SteBe01/SpacePropulsion/cad/Engine.SLDASM

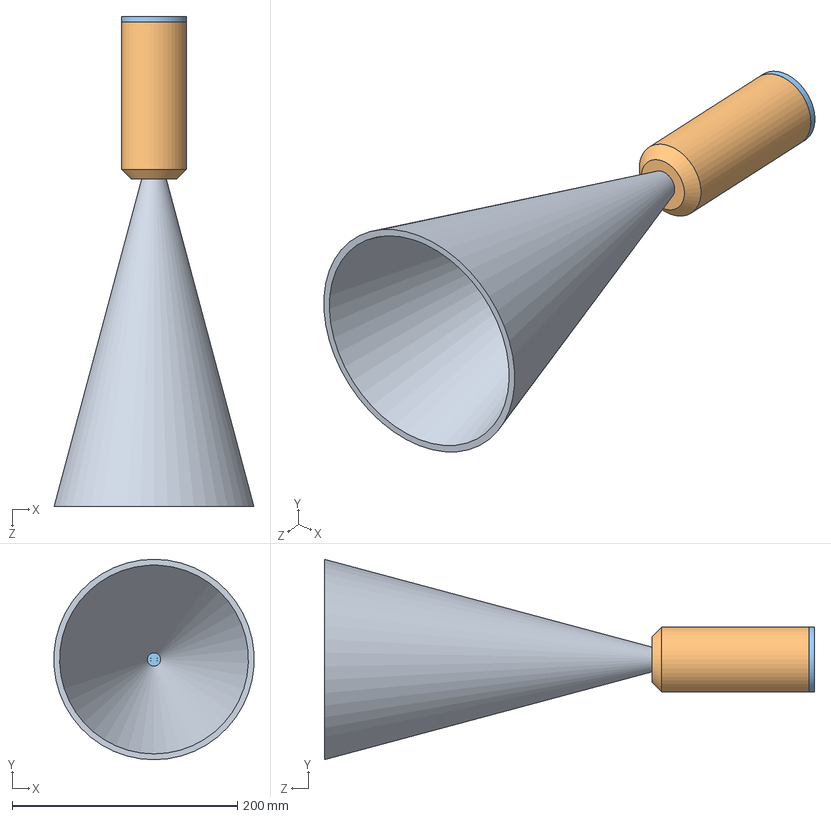
[picture p20: CAD file, 2024-04-17]
cad/Engine.SLDASM
177.7 x 178.2 x 435.8 mm
Injection_plate
Combustion_chamber_and_convergent
Nozzle_conical
