SteBe01/SpacePropulsion/cad/FEM.SLDPRT

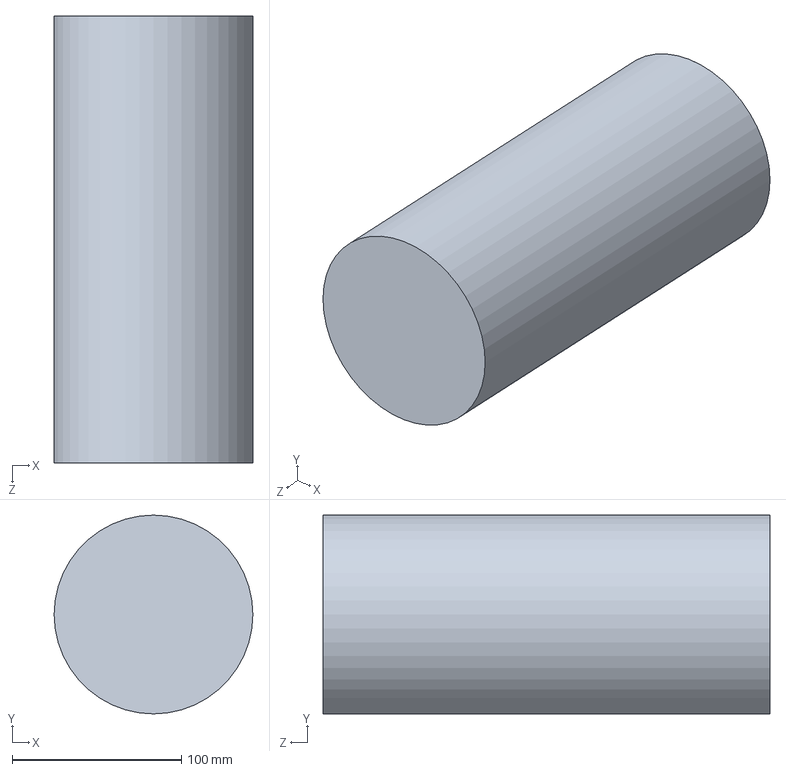
[picture p21: CAD file, 2024-04-17]
cad/FEM.SLDPRT
117.4 x 117.4 x 264.0 mm
