SteBe01/SpacePropulsion/cad/Rao1.SLDPRT

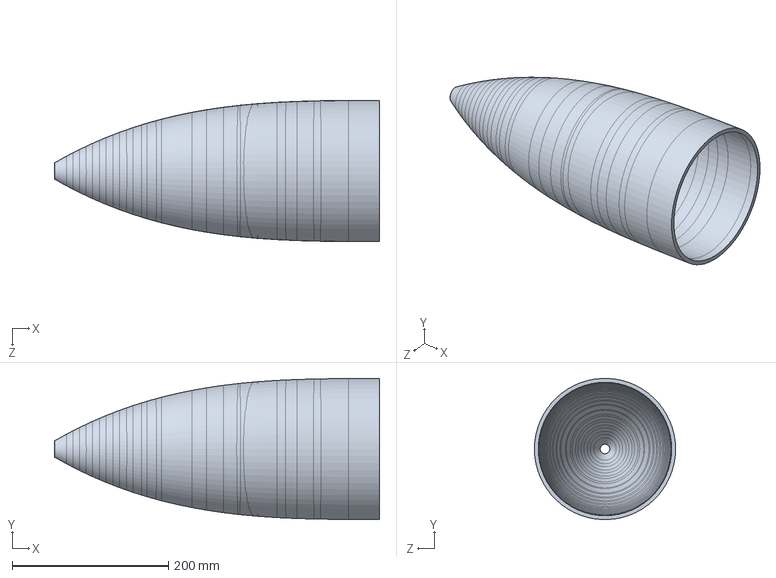
[picture p22: CAD file, 2024-04-17]
cad/Rao1.SLDPRT
415.6 x 180.3 x 180.6 mm
