SteBe01/SpacePropulsion/cad/Rao2.SLDPRT

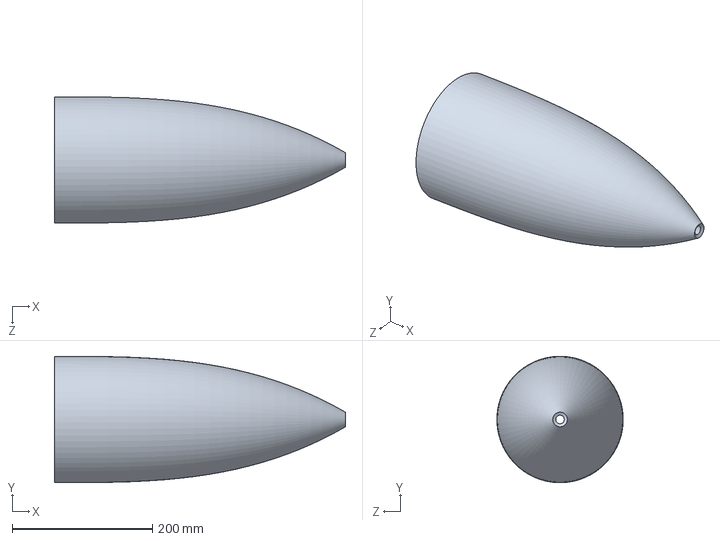
[picture p23: CAD file, 2024-04-17]
cad/Rao2.SLDPRT
415.6 x 180.6 x 180.5 mm
