SteBe01/SpacePropulsion/cad/Nozzle_conical.SLDPRT

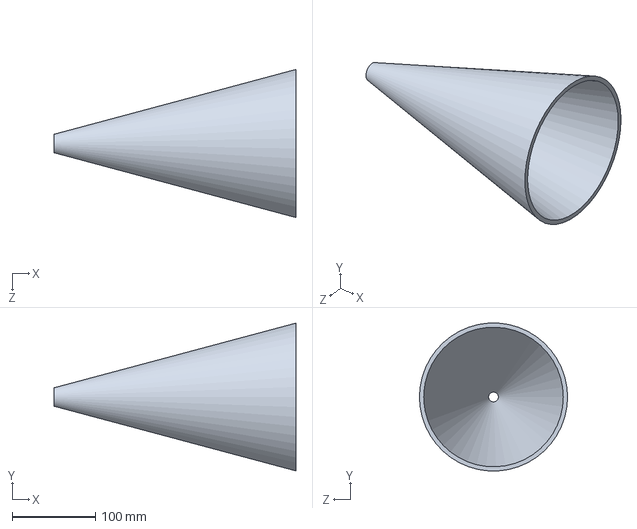
[picture p24: CAD file, 2024-04-17]
cad/Nozzle_conical.SLDPRT
291.0 x 177.7 x 178.2 mm
