SteBe01/SpacePropulsion/cad/Injection_plate.SLDPRT

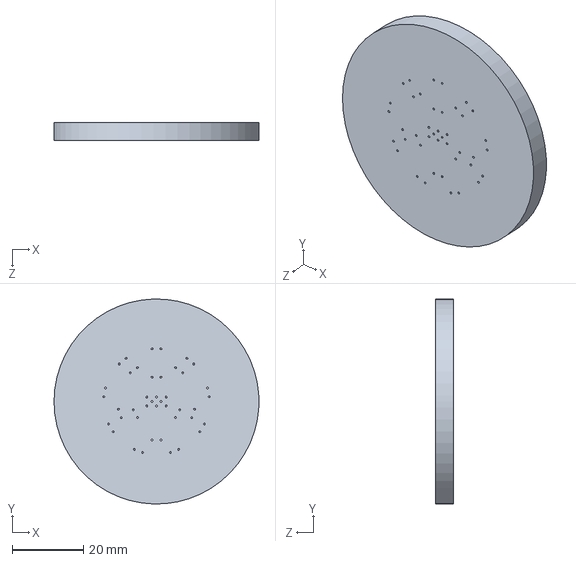
[picture p25: CAD file, 2024-04-17]
cad/Injection_plate.SLDPRT
57.6 x 57.6 x 5.00 mm
