SteBe01/SpacePropulsion/cad/Tank_ox.SLDPRT

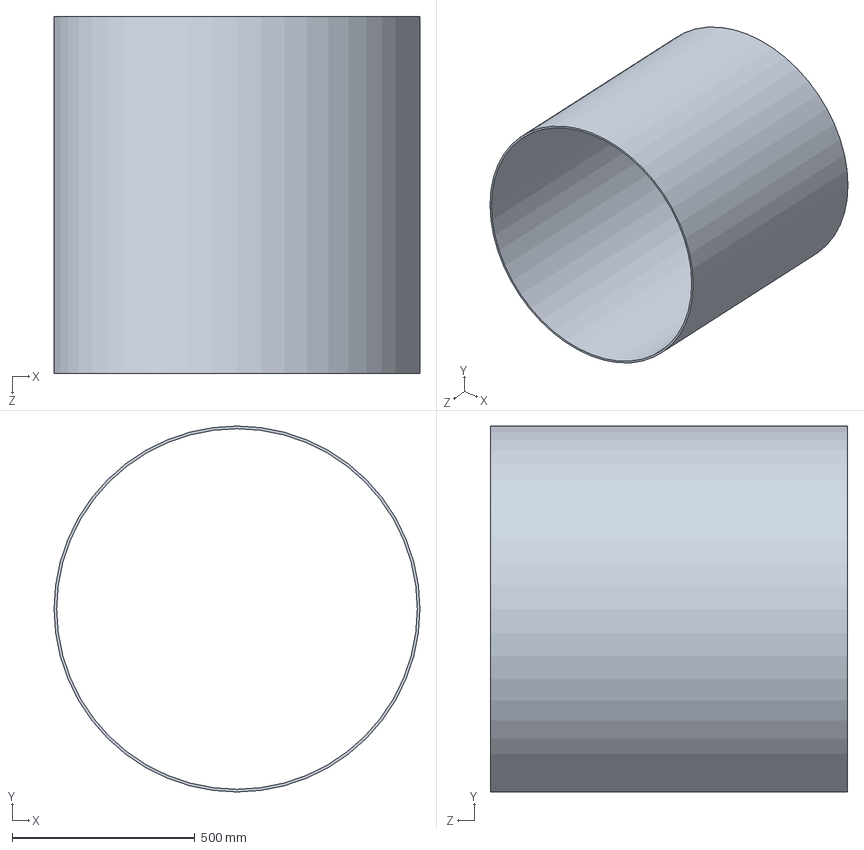
[picture p26: CAD file, 2024-04-14]
cad/Tank_ox.SLDPRT
1000.0 x 1000.0 x 975.5 mm
