SteBe01/SpacePropulsion/cad/Tank_fu.SLDPRT

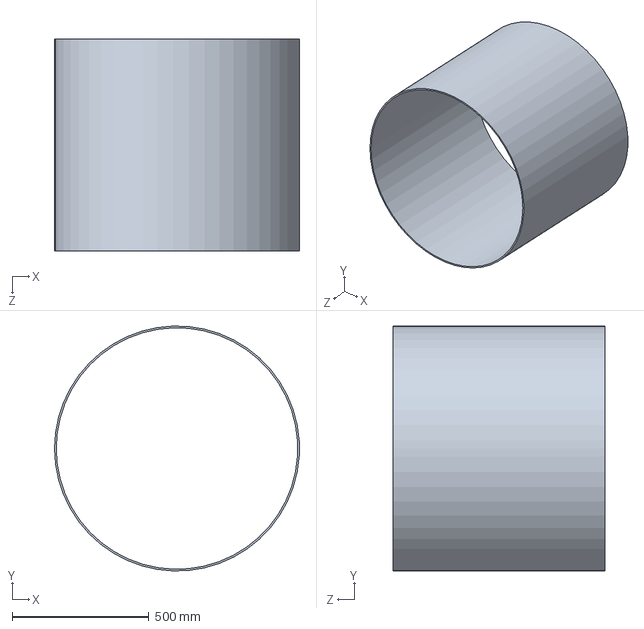
[picture p27: CAD file, 2024-04-14]
cad/Tank_fu.SLDPRT
896.6 x 896.1 x 776.3 mm
