SteBe01/SpacePropulsion/cad/Combustion_chamber_and_convergent.SLDPRT

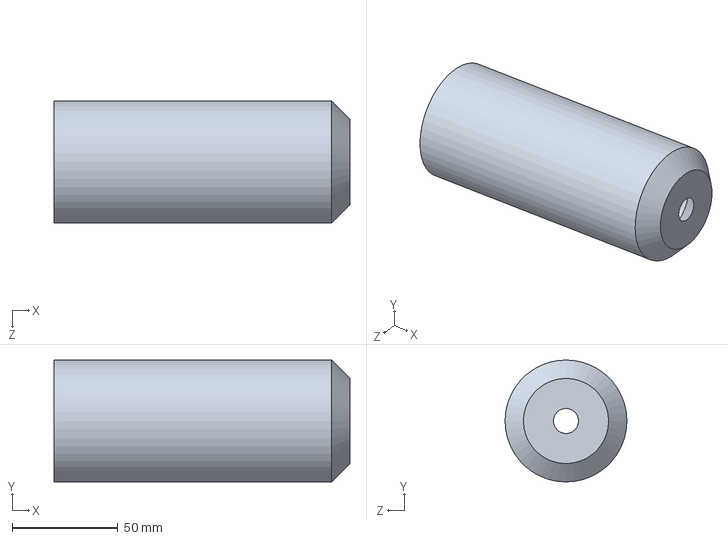
[picture p28: CAD file, 2024-04-14]
cad/Combustion_chamber_and_convergent.SLDPRT
139.8 x 57.6 x 57.6 mm
