SteBe01/SpacePropulsion/(commit log)

2024-04-08 Create live script with commented preliminary analysis to better keep track of computations and assumptions done
2024-04-09 Fix pressure losses
2024-04-10 Combined Nozzle and Combustion Chamber
2024-04-10 Updated nozzle and cc for cases of ref val 0.6 or 1
2024-04-10 Added topdown simulation, temporary fix for pressure losses in pre
2024-04-10 Removed pressure_loss.m
2024-04-10 Now the tube velocity values are computed and not hardcoded
2024-04-10 Nozzle losses
2024-04-10 Added nozzle losses and iter. number
2024-04-10 added masses and volumes of injector plates
2024-04-11 D tube added
2024-04-12 added rpa.cfg (RPA v.1.2 Lite Edition)
    [rpa.cfg]
2024-04-12 Nozzle conical plot, 0 for con, 1 for RAO
2024-04-12 fix nozzle_shape
2024-04-12 added temperature
2024-04-12 rho nozzle
2024-04-12 fuck tanks, ste fixa il resto
2024-04-12 Gnielinski case, must be reviewed
2024-04-13 Better computations for mass flow rate from CEA
2024-04-13 new script for nozzle optimization
2024-04-13 added cad model,
    [Combustion_chamber.SLDPRT, Engine.SLDASM, Injection_plate.SLDPRT, Nozzle_conv_div_conical.SLDPRT, Tank_fu.SLDPRT, Tank_ox.SLDPRT]
2024-04-13 added rho nozzle (divergent)
2024-04-14 Correction on Cf and eta nozzle
2024-04-14 added thickness injection plate
2024-04-14 new cad design
    [Combustion_chamber.SLDPRT, Combustion_chamber_and_convergent.SLDPRT, Engine.SLDASM, Injection_plate.SLDPRT, Nozzle_conical.SLDPRT, Nozzle_conv_div_conical.SLDPRT, Tank_fu.SLDPRT, Tank_ox.SLDPRT]
2024-04-15 Set min design pressure for 2% margin on mass
2024-04-17 Final code version, final CAD (and FEM)
    [Engine.SLDASM, FEM.SLDPRT, Injection_plate.SLDPRT, Nozzle_conical.SLDPRT, Rao1.SLDPRT, Rao2.SLDPRT]
2024-04-17 Final code, added report
    [rpa.cfg]
